f1133/CAN-BUS-FOC-Actuator/README.md

# CAN-BUS FOC Actuator

A CAN-bus FOC controller for cycloidal robot-arm joints, built as a **carrier
board for the SimpleFOC Mini** (DRV8313): on-board STM32G431, 2-shunt inline
current sensing (INA240), AS5600 motor encoder plus two SPI ports for a
joint-side absolute encoder, 1 Mbps CAN, three boards on one bus. Designed
around the parts already on hand (Robu.in invoice 3680169, connector order
ST030926127752, SimpleFOC Mini, STM32G431CBT6, ERJ8CW shunts, SS14, THT kit)
with four things left to buy.

## Spin-1 design point

| | |
|---|---|
| Power stage | SimpleFOC Mini (DRV8313) plugged into the carrier — 3-PWM + EN, nFAULT → TIM1 break |
| DC bus | **12 V only** (8–15 V), one shared 5 A PSU over the CAN harness, passed through each board |
| Phase current | ≤ 2.5 A peak (DRV8313; INA240 range matches) — at 12 V a gimbal winding limits it first, see `docs/08` |
| Current sense | 2 × INA240A1 inline, one 30 mΩ per phase between the Mini and the motor |
| Power | AMS1117-3.3 straight off the 12 V bus — no switcher (0.66 W, pour copper on the tab) |
| MCU | STM32G431CBT6 @ 170 MHz — CORDIC, FMAC, dual ADC |
| Encoders | J3: AS5600 (I2C) + NTC on one 5-pin cable · J4/J5: SPI (MT6701 / AS5047P), motor side and output side |
| Bus | SN65HVD230 1 Mbps classic CAN (TCAN332 drop-in), node ID by solder straps |
| PCB | ~60 × 60 mm, 2-layer, Lion Circuits |
| Spin 2 | discrete bridge with the AO3400s on hand → ±5 A (documented, `-DBRIDGE_DISCRETE`) |

## Read in order

1. [`docs/01-parts-analysis.md`](docs/01-parts-analysis.md) — what the parts on hand can do, sufficiency for 3 boards, the 4-line buy list.
2. [`docs/02-hardware-architecture.md`](docs/02-hardware-architecture.md) — block diagram, power tree, Mini socket, sensing, connectors, protection.
3. [`docs/03-pin-assignment.md`](docs/03-pin-assignment.md) — LQFP-48 pin map with the Mini header mapping, conflicts found and resolved.
4. [`docs/04-firmware-capability.md`](docs/04-firmware-capability.md) — loop structure, CPU budget, dual-encoder scheme, bring-up order.
5. [`docs/05-can-protocol.md`](docs/05-can-protocol.md) — frame layout.
6. [`docs/06-spin1-decisions.md`](docs/06-spin1-decisions.md) — decisions, ranked bottleneck upgrades, encoder mounting, first-PCB checklist.
7. [`docs/07-single-board-bom-and-wiring.md`](docs/07-single-board-bom-and-wiring.md) — module wiring (what plugs into what), the three-joint harness, the cable list, pin-by-pin connections and the designator-level BOM (generated).
8. [`docs/08-board-spec-and-arm-capability.md`](docs/08-board-spec-and-arm-capability.md) — final board specification and what the arm gets from it (generated).

## KiCad project

`hardware/kicad/` holds a generated, verified KiCad 7 project — schematic,
board outline, project symbol/footprint libraries. See
[`hardware/kicad/README.md`](hardware/kicad/README.md). The electrical source
of truth is `tools/board_design.py`; `tools/check_design.py` has KiCad export
the netlist and compares it pin-for-pin against that design.

## Checks

```sh
python3 tools/check_pinmap.py          # 0 conflicts on hardware/pinmap/pinmap.csv
python3 tools/check_bom.py --boards 3  # shortfall table from hardware/bom/*.csv
python3 hardware/calc/design_calcs.py  # every number quoted in docs/
python3 tools/gen_board_docs.py        # regenerates docs/07, docs/08, hardware/wiring/wiring_diagram.svg and the build-sheet page
python3 tools/gen_kicad.py             # regenerates hardware/kicad/ from tools/board_design.py
python3 tools/check_design.py          # kicad-cli netlist vs board_design.py, pin for pin
```

## Layout

```
docs/                     analysis, architecture, decisions
hardware/bom/             inventory.csv (what exists) · per_board.csv (what spin 1 needs)
hardware/calc/            design_calcs.py — sense range, DRV8313 thermal, buck/SS14, cap ratings, PWM, CAN load, AS5600-through-cycloidal, spin-2 reference
hardware/pinmap/          pinmap.csv — single source of truth for the MCU pins
hardware/kicad/           generated KiCad 7 project (schematic, outline, project libs)
hardware/vendor/          SimpleFOC Mini board file (MIT) — the socket footprint is generated from it
firmware/include/         foc_config.h — constants derived from the above (-DBRIDGE_DISCRETE for spin 2)
tools/                    check_pinmap.py · check_bom.py
```

## Next

- [ ] Confirm counts on hand: SimpleFOC Mini ≥ 3, STM32G431CBT6 ≥ 3, ERJ8CWFR030V ≥ 6
- [ ] Confirm the cycloidal ratio and the motor part number (Kv, R); check whether the Minis have male or female headers
- [ ] Buy: male pin header strip, SMBJ15A ×4 (optional), 2-layer PCB ×5
- [ ] Import the netlist into the PCB, place and route the 2-layer board
- [ ] Firmware: SimpleFOC-library bring-up first, then the bare-metal FOC core
