f1133/CAN-BUS-FOC-Actuator/docs/08-board-spec-and-arm-capability.md

# 08 — Board specification & arm capability (spin 1)

Generated by `tools/gen_board_docs.py`; the arm numbers come from `hardware/calc/arm_model.py`.

## Electrical

| | |
|---|---|
| DC bus | 12 V from one shared 5 A PSU over the harness; 8–15 V, the ceiling set by the AMS1117 rather than the DRV8313 |
| Power pass-through | J1 in → J13 out on a ≥ 2 mm trace; the first joint's board carries the whole 5 A |
| Power stage | SimpleFOC Mini (DRV8313): 3-PWM + EN, internal dead time, OCP / UVLO / thermal → nFAULT |
| Phase current | 2.5 A peak (driver) — at 12 V a gimbal motor is voltage-limited to (12 V/√3)/R first; ~1.5 A rms continuous on the Mini's thermal budget |
| Current sense | 2 × INA240A1 inline, 30 mΩ per phase: 0.60 V/A, ±2.5 A full scale, 1.3 mA/LSB, Ic reconstructed |
| PWM / loops | 20 kHz centre-aligned (12.1-bit) · current 20 kHz · velocity 4 kHz · position 1 kHz |
| Logic supply | AMS1117-3.3 straight off the 12 V bus — no switcher. 0.66 W at the itemised 76 mA load; pour copper on the tab. Its 18 V abs max is what fixes the bus at 12 V |
| Sensing | VBUS ÷ 10.1 (8 mV/LSB), motor NTC (10 k, B 3950), MCU die temperature |

## Interfaces

| | |
|---|---|
| CAN | SN65HVD230, classic CAN 1 Mbps, 11-bit IDs, node ID 0–7 by solder straps, 120 Ω termination by jumper on the end boards; 3 joints at 1 kHz ≈ 68 % bus load |
| Motor encoder | AS5600 on the motor (I2C, 12-bit, 1 kHz reads, CONF SF = 2×) on J3 with the winding NTC |
| Joint encoder | J5 SPI (MT6701 / AS5047P, 14-bit) on the cycloidal output — absolute joint angle at power-on |
| Encoder upgrade | J4 SPI for a motor-side MT6701 / AS5047P when speed or latency outgrows the AS5600 |
| Debug | SWD (J11) · UART 115200 (J12) · status LED · SimpleFOC-library compatible pin map |

## Protection

| | |
|---|---|
| Hardware | DRV8313 nFAULT → TIM1 break (outputs idle in one clock) · EN pulled low through reset · bridge-disable jumper R20 |
| Firmware | |I| > 2.8 A · VBUS outside 8–15 V · NTC > 100 °C · encoder error → torque off; CAN heartbeat timeout 100 ms → brake |
| Input | keyed JST-VH, optional SMBJ15A clamp, 2 × 470 µF bulk |

## Physical

| | |
|---|---|
| Board | ~60 × 60 mm, 2-layer 1 oz, Lion Circuits; bottom layer ground pour; 4 × M3 on a 40 mm square + 1 under the Mini |
| Dissipation | ≈ 0.5 W on the carrier; ≈ 1.35 W on the Mini at 1.5 A rms (thermal pad to the carrier pour) |
| Connectors | J1/J13/J6 JST-VH 2P · J2 motor JST-XH 3P · J9/J10 CAN JST-XH 3P · J3 JST-XH 5P · J4/J5/J11/J12 0.1" headers · J7/J8 Mini socket |

## What the arm gets from it

Torque = Kt · Iq · ratio · η with Iq = min(2.5 A, (Vbus/√3)/R). Cycloidal ×15 at 85% is a placeholder; motor rows are typical AS5600-gimbal values — replace with the real motor.

| Motor (typical) | Kv | R | Iq stall | Limit | Motor N·m | Joint N·m | Joint °/s | Bus A holding | AS5600 reads/cycle | Lifts at 0.3 m | Joint N·m at 24 V |
|---|---|---|---|---|---|---|---|---|---|---|---|
| 2804-class gimbal (typical) | 100 | 10.0 Ω | 0.69 A | voltage (V/R) | 0.057 | **0.73** | 408 | 0.63 A | 8.4 | 0.25 kg | 1.46 |
| 3506 / 4108-class gimbal (typical) | 70 | 6.0 Ω | 1.15 A | voltage (V/R) | 0.136 | **1.74** | 286 | 1.03 A | 12.0 | 0.59 kg | 3.48 |
| low-resistance outrunner (typical) | 200 | 0.5 Ω | 2.50 A | driver 2.5 A | 0.103 | **1.32** | 816 | 0.42 A | 4.2 | 0.45 kg | 1.32 |

* Three joints all holding at stall draw ≤ 3.1 A of the 5 A PSU with these motors.
* At 12 V the winding resistance, not the driver, sets torque for gimbal motors; 24 V doubles it with no board change.
* AS5600 stays ≥ 10 reads per electrical cycle to ~1000 rpm; faster motors want the J4 SPI encoder.
* Joint-absolute position comes from the J5 encoder on the cycloidal output.
