f1133/CAN-BUS-FOC-Actuator/hardware/kicad/can-foc-actuator.kicad_sch

## KiCad design hardware/kicad/can-foc-actuator.kicad_sch (2026-09-14, an earlier design)

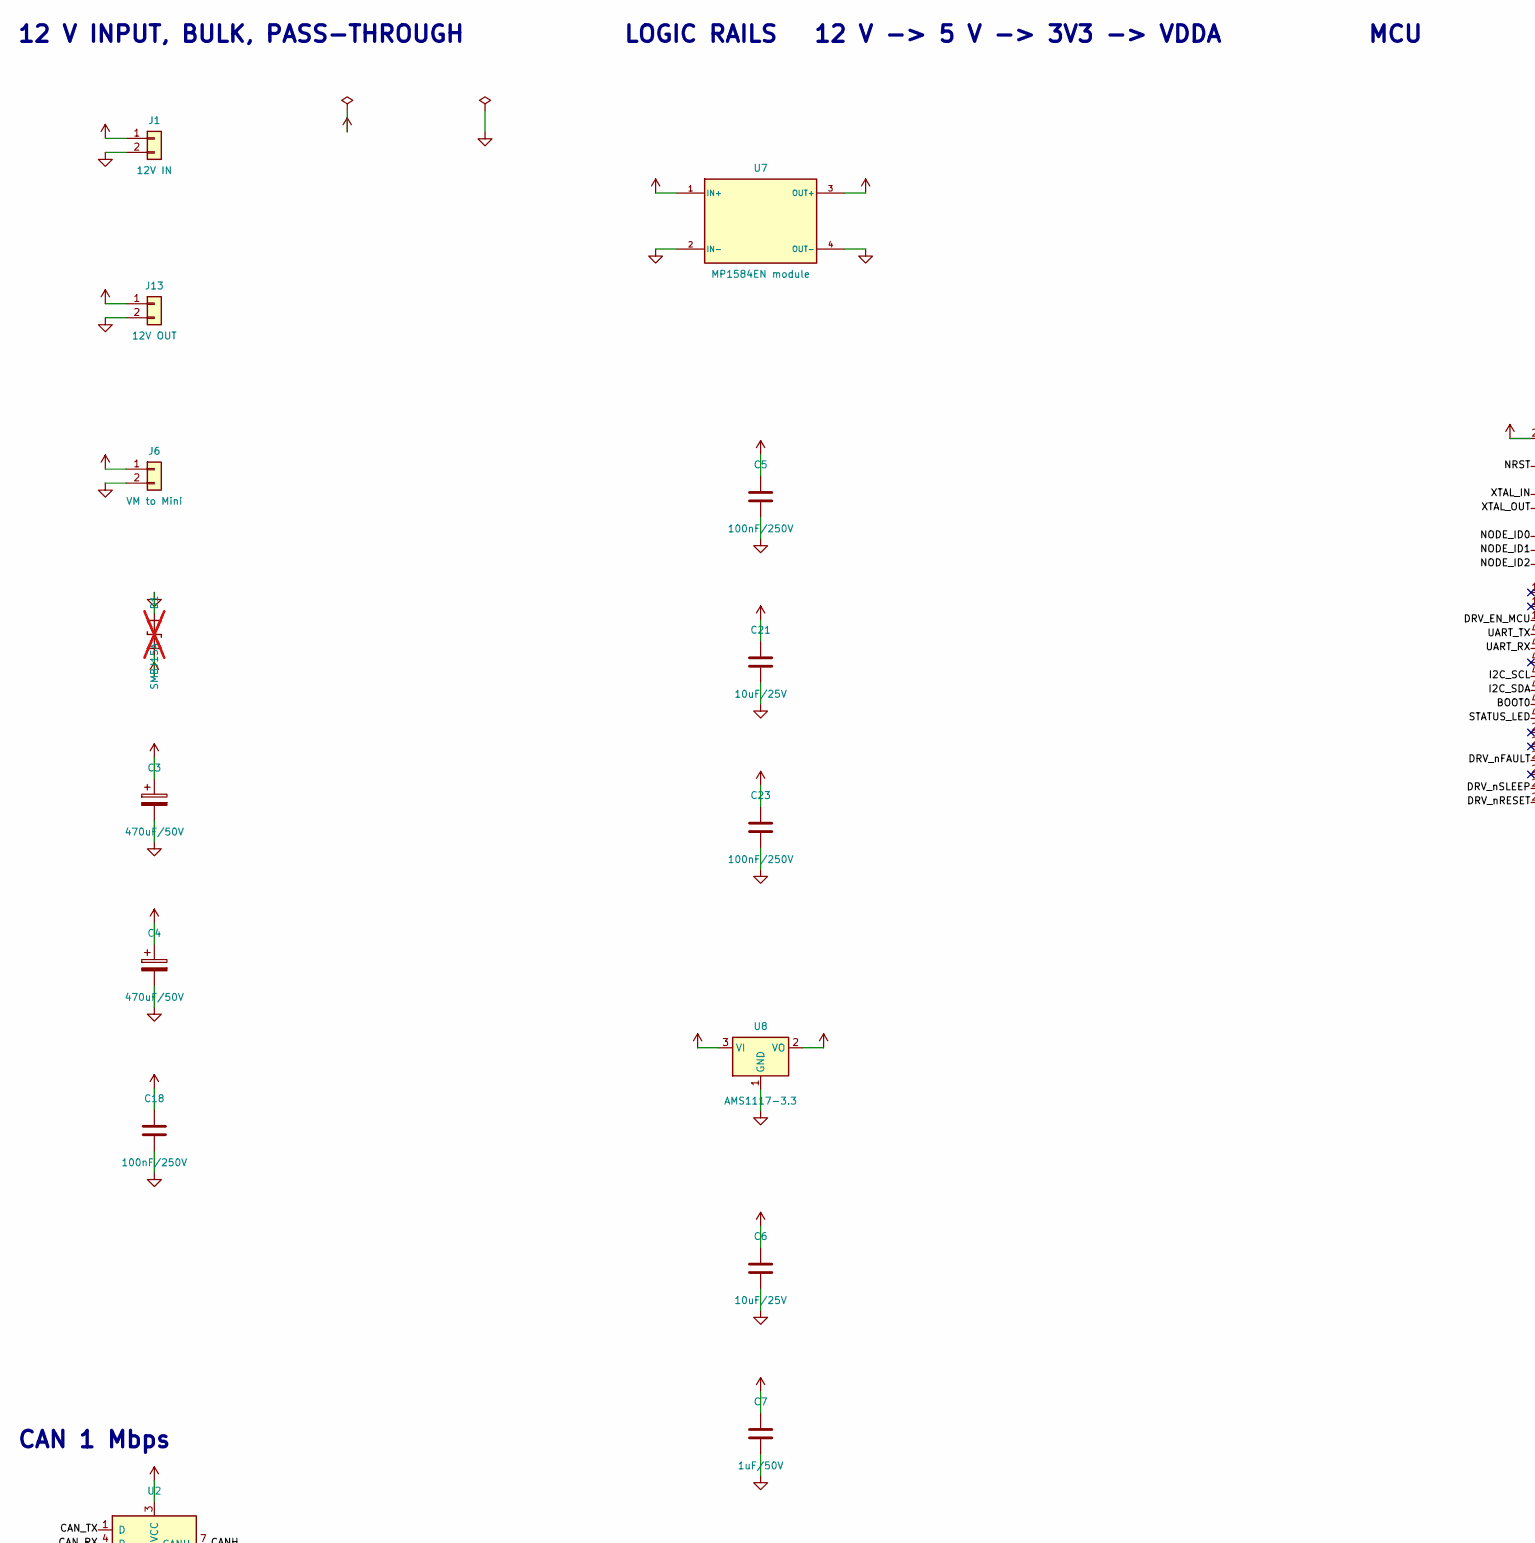
[picture p1: schematic can-foc-actuator.kicad_sch, part in row 1, column 1]

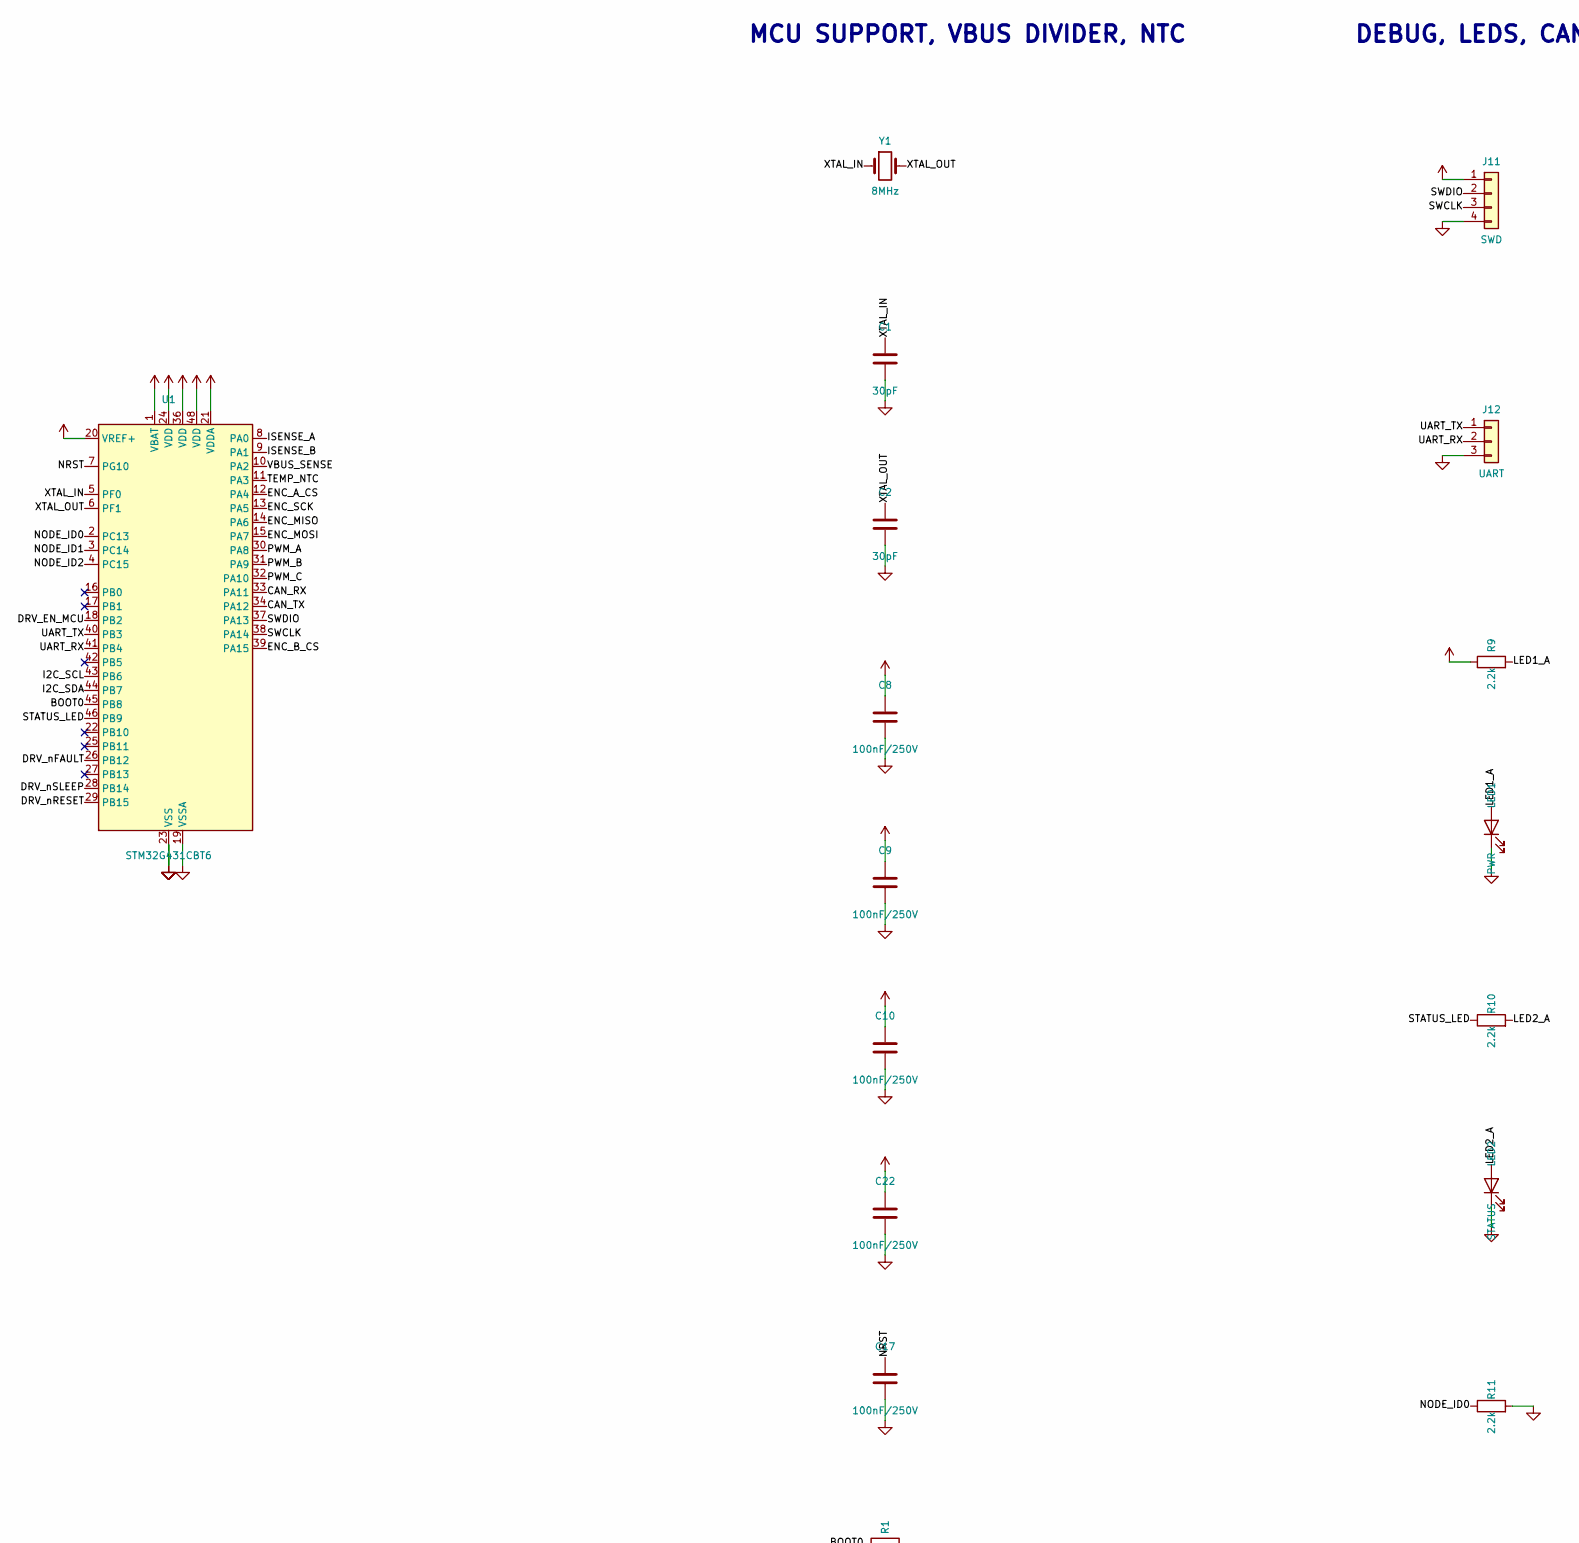
[picture p2: schematic can-foc-actuator.kicad_sch, part in row 1, column 2]

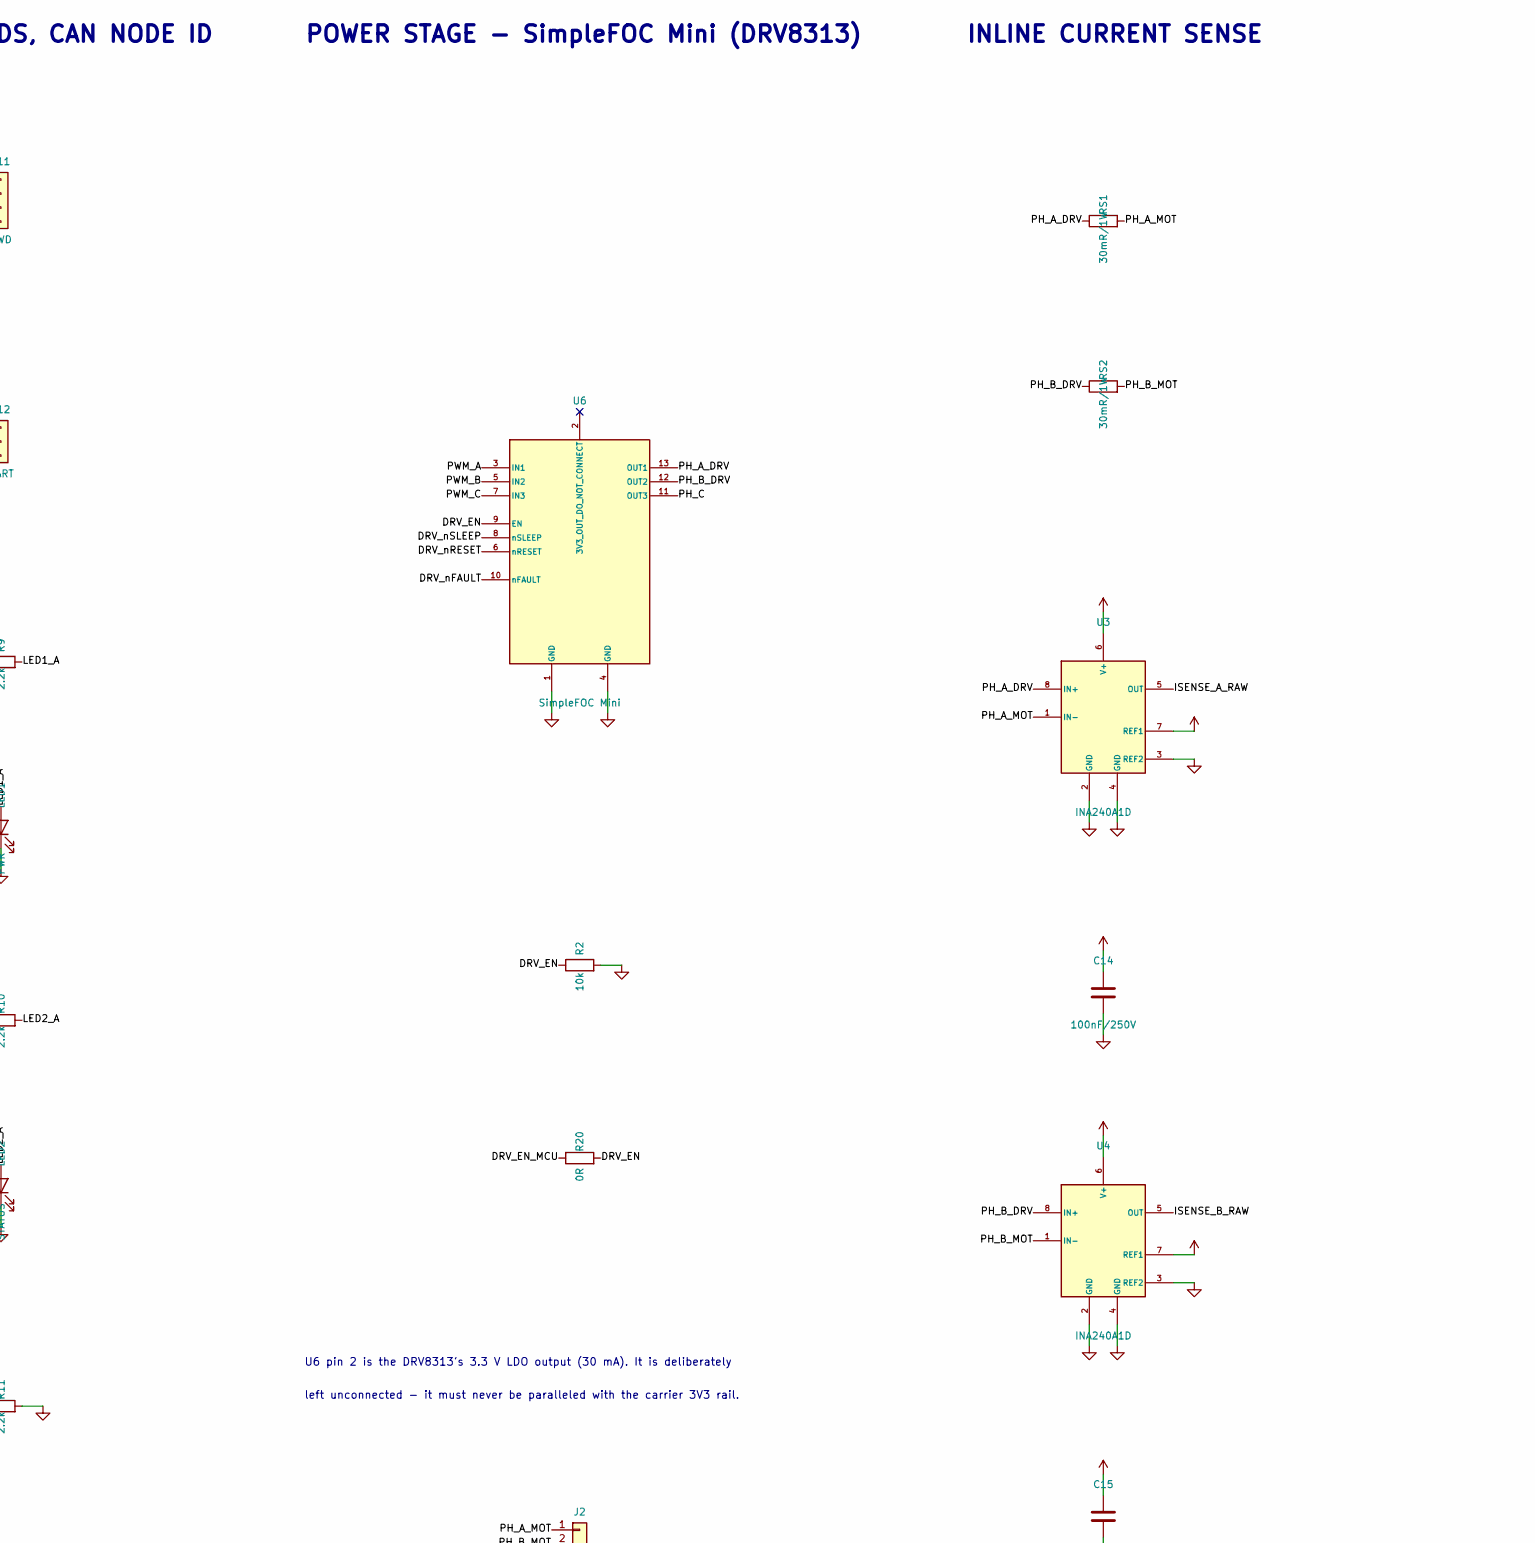
[picture p3: schematic can-foc-actuator.kicad_sch, part in row 1, column 3]

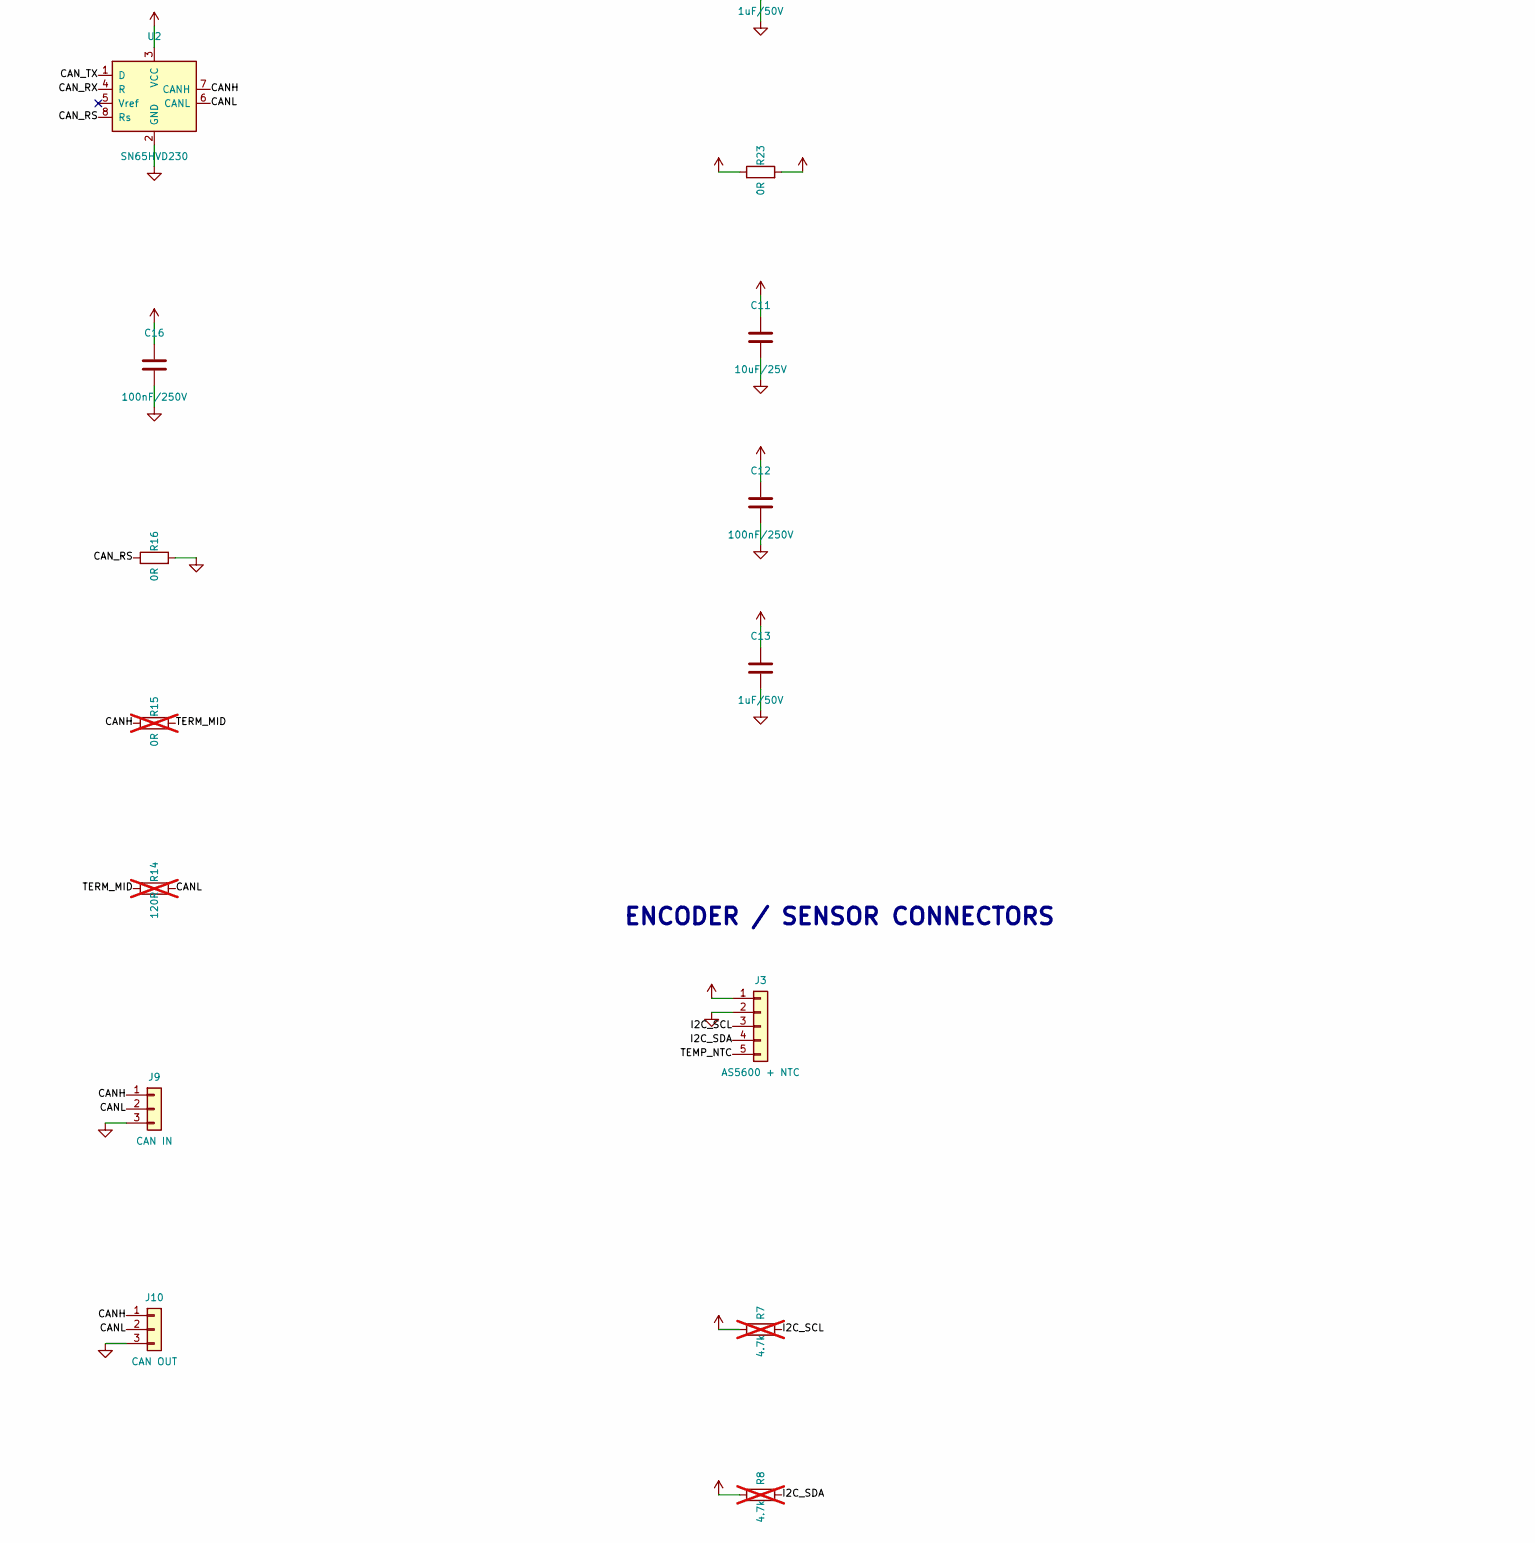
[picture p4: schematic can-foc-actuator.kicad_sch, part in row 2, column 1]

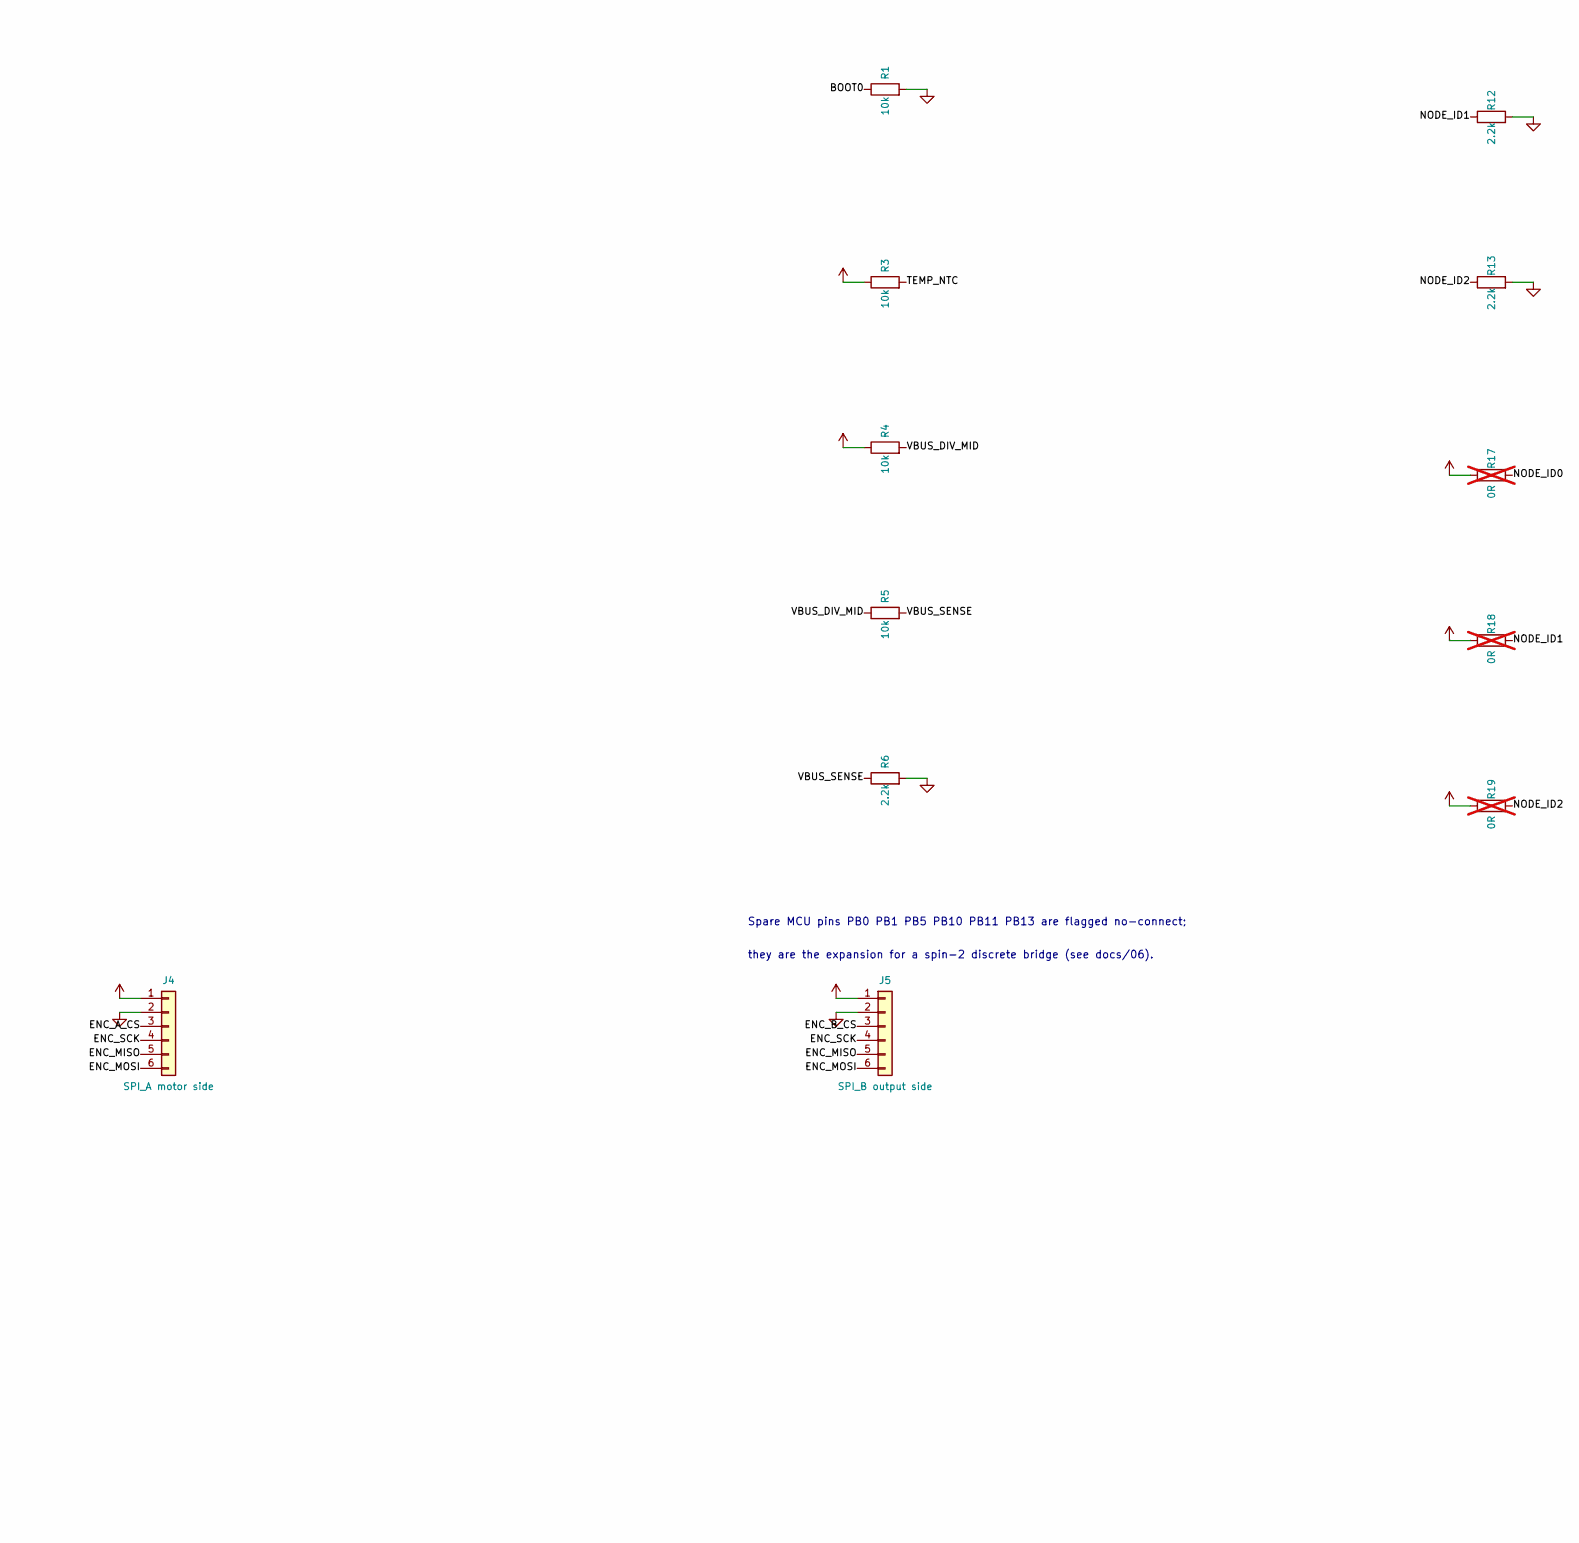
[picture p5: schematic can-foc-actuator.kicad_sch, part in row 2, column 2]

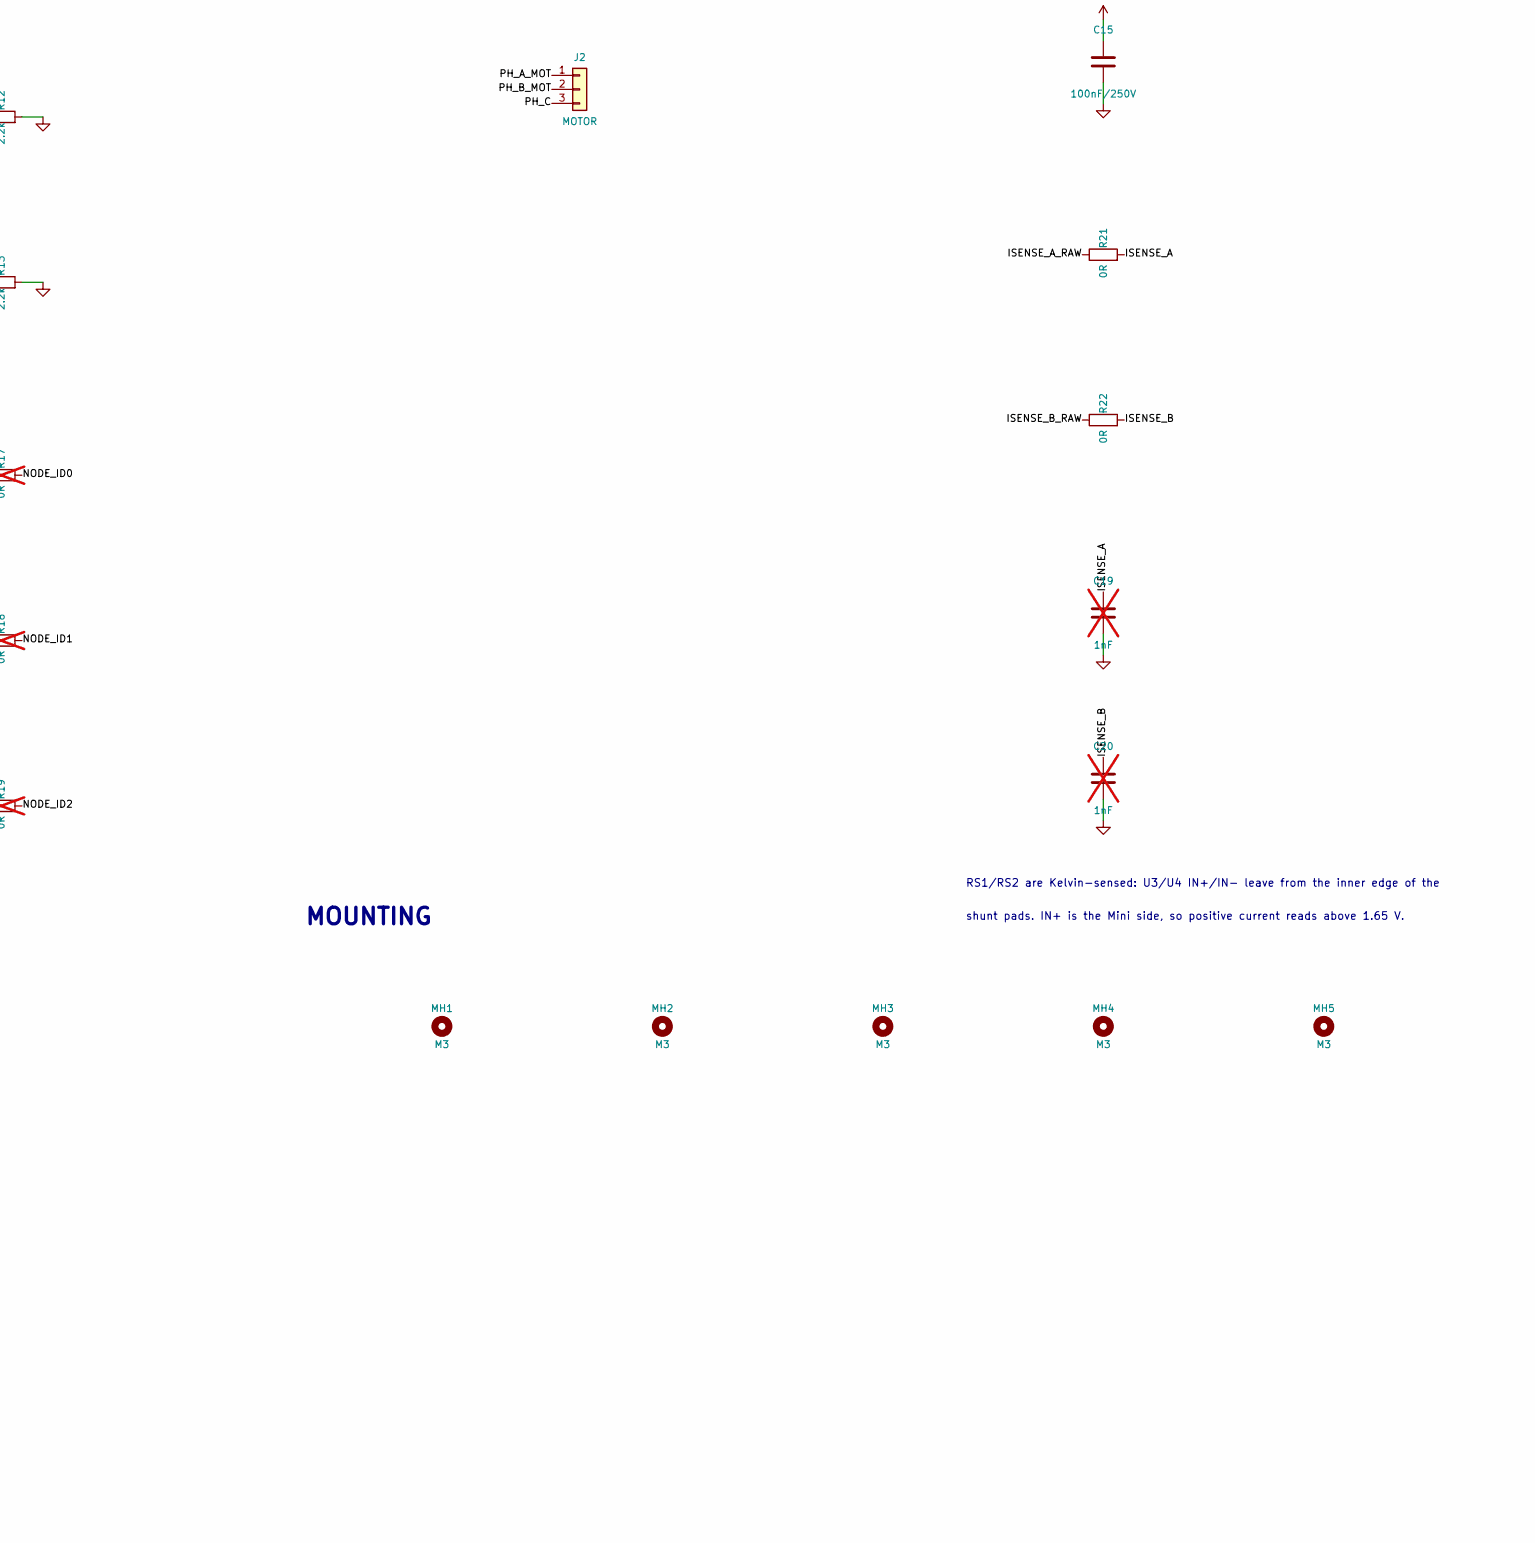
[picture p6: schematic can-foc-actuator.kicad_sch, part in row 2, column 3]

Parts:
C1, C2: 30pF; C_1206_3216Metric
C3, C4: 470uF/50V; CP_Elec_10x10.5
C5, C8, C9, C10, C12, C14, C15, C16, C17, C18, C22, C23: 100nF/250V; C_1206_3216Metric
C6, C11, C21: 10uF/25V; C_1206_3216Metric
C7, C13: 1uF/50V; C_1206_3216Metric
C19, C20: 1nF; C_1206_3216Metric; not fitted
D1: SMBJ15A; D_SMB; not fitted
J1: 12V IN; JST_VH_B2P-VH_1x02_P3.96mm_Vertical
J2: MOTOR; JST_XH_B3B-XH-A_1x03_P2.50mm_Vertical
J3: AS5600 + NTC; JST_XH_B5B-XH-A_1x05_P2.50mm_Vertical
J4: SPI_A motor side; PinHeader_1x06_P2.54mm_Vertical
J5: SPI_B output side; PinHeader_1x06_P2.54mm_Vertical
J6: VM to Mini; JST_VH_B2P-VH_1x02_P3.96mm_Vertical
J9: CAN IN; JST_XH_B3B-XH-A_1x03_P2.50mm_Vertical
J10: CAN OUT; JST_XH_B3B-XH-A_1x03_P2.50mm_Vertical
J11: SWD; PinHeader_1x04_P2.54mm_Vertical
J12: UART; PinHeader_1x03_P2.54mm_Vertical
J13: 12V OUT; JST_VH_B2P-VH_1x02_P3.96mm_Vertical
LED1: PWR; LED_1206_3216Metric
LED2: STATUS; LED_1206_3216Metric
MH1, MH2, MH3, MH4, MH5: M3; MountingHole_3.2mm_M3
R1, R2, R3, R4, R5: 10k; R_1206_3216Metric
R6, R9, R10, R11, R12, R13: 2.2k; R_1206_3216Metric
R7, R8: 4.7k; R_1206_3216Metric; not fitted
R14: 120R; R_1206_3216Metric; not fitted
R15, R17, R18, R19: 0R; R_1206_3216Metric; not fitted
R16, R20, R21, R22, R23: 0R; R_1206_3216Metric
RS1, RS2: 30mR/1W; R_1206_3216Metric
U1: STM32G431CBT6; LQFP-48_7x7mm_P0.5mm
U2: SN65HVD230; SOIC-8_3.9x4.9mm_P1.27mm
U3, U4: INA240A1D; SOIC-8_3.9x4.9mm_P1.27mm
U6: SimpleFOC Mini; SimpleFOC_Mini_Socket
U7: MP1584EN module; MP1584_Module_4pin
U8: AMS1117-3.3; SOT-223-3_TabPin2
Y1: 8MHz; Crystal_SMD_HC49-SD_HandSoldering

Connections:
+3V3: C6.1, C7.1, C8.1, C9.1, C10.1, C14.1, C15.1, C16.1, C22.1, J3.1, J4.1, J5.1, J11.1, R3.1, R7.1, R8.1, R9.1, R17.1, R18.1, R19.1, R23.1, U1.1 (VBAT), U1.24 (VDD), U1.36 (VDD), U1.48 (VDD), U2.3 (VCC), U3.6 (V+), U3.7 (REF1), U4.6 (V+), U4.7 (REF1), U8.2 (VO)
+5V: C21.1, C23.1, U7.3 (OUT+), U8.3 (VI)
BOOT0: R1.1, U1.45 (PB8)
CANH: J9.1, J10.1, R15.1, U2.7 (CANH)
CANL: J9.2, J10.2, R14.2, U2.6 (CANL)
CAN_RS: R16.1, U2.8 (Rs)
CAN_RX: U1.33 (PA11), U2.4 (R)
CAN_TX: U1.34 (PA12), U2.1 (D)
DRV_EN: R2.1, R20.2, U6.9 (EN)
DRV_EN_MCU: R20.1, U1.18 (PB2)
DRV_nFAULT: U1.26 (PB12), U6.10 (nFAULT)
DRV_nRESET: U1.29 (PB15), U6.6 (nRESET)
DRV_nSLEEP: U1.28 (PB14), U6.8 (nSLEEP)
ENC_A_CS: J4.3, U1.12 (PA4)
ENC_B_CS: J5.3, U1.39 (PA15)
ENC_MISO: J4.5, J5.5, U1.14 (PA6)
ENC_MOSI: J4.6, J5.6, U1.15 (PA7)
ENC_SCK: J4.4, J5.4, U1.13 (PA5)
GND: C1.2, C2.2, C3.2, C4.2, C5.2, C6.2, C7.2, C8.2, C9.2, C10.2, C11.2, C12.2, C13.2, C14.2, C15.2, C16.2, C17.2, C18.2, C19.2, C20.2, C21.2, C22.2, C23.2, D1.2 (A2), J1.2, J3.2, J4.2, J5.2, J6.2, J9.3, J10.3, J11.4, J12.3, J13.2, LED1.1 (K), LED2.1 (K), R1.2, R2.2, R6.2, R11.2, R12.2, R13.2, R16.2, U1.19 (VSSA), U1.23 (VSS), U1.35 (VSS), U1.47 (VSS), U2.2 (GND), U3.2 (GND), U3.3 (REF2), U3.4 (GND), U4.2 (GND), U4.3 (REF2), U4.4 (GND), U6.1 (GND), U6.4 (GND), U7.2 (IN-), U7.4 (OUT-), U8.1 (GND)
I2C_SCL: J3.3, R7.2, U1.43 (PB6)
I2C_SDA: J3.4, R8.2, U1.44 (PB7)
ISENSE_A: C19.1, R21.2, U1.8 (PA0)
ISENSE_A_RAW: R21.1, U3.5 (OUT)
ISENSE_B: C20.1, R22.2, U1.9 (PA1)
ISENSE_B_RAW: R22.1, U4.5 (OUT)
LED1_A: LED1.2 (A), R9.2
LED2_A: LED2.2 (A), R10.2
NODE_ID0: R11.1, R17.2, U1.2 (PC13)
NODE_ID1: R12.1, R18.2, U1.3 (PC14)
NODE_ID2: R13.1, R19.2, U1.4 (PC15)
NRST: C17.1, U1.7 (PG10)
PH_A_DRV: RS1.1, U3.8 (IN+), U6.13 (OUT1)
PH_A_MOT: J2.1, RS1.2, U3.1 (IN-)
PH_B_DRV: RS2.1, U4.8 (IN+), U6.12 (OUT2)
PH_B_MOT: J2.2, RS2.2, U4.1 (IN-)
PH_C: J2.3, U6.11 (OUT3)
PWM_A: U1.30 (PA8), U6.3 (IN1)
PWM_B: U1.31 (PA9), U6.5 (IN2)
PWM_C: U1.32 (PA10), U6.7 (IN3)
STATUS_LED: R10.1, U1.46 (PB9)
SWCLK: J11.3, U1.38 (PA14)
SWDIO: J11.2, U1.37 (PA13)
TEMP_NTC: J3.5, R3.2, U1.11 (PA3)
TERM_MID: R14.1, R15.2
UART_RX: J12.2, U1.41 (PB4)
UART_TX: J12.1, U1.40 (PB3)
VBUS: C3.1, C4.1, C5.1, C18.1, D1.1 (A1), J1.1, J6.1, J13.1, R4.1, U7.1 (IN+)
VBUS_DIV_MID: R4.2, R5.1
VBUS_SENSE: R5.2, R6.1, U1.10 (PA2)
VDDA: C11.1, C12.1, C13.1, R23.2, U1.20 (VREF+), U1.21 (VDDA)
XTAL_IN: C1.1, U1.5 (PF0), Y1.1
XTAL_OUT: C2.1, U1.6 (PF1), Y1.2

Notes on the sheet:
12 V INPUT, BULK, PASS-THROUGH
CAN 1 Mbps
LOGIC RAILS 12 V -> 5 V -> 3V3 -> VDDA
ENCODER / SENSOR CONNECTORS
MCU
MCU SUPPORT, VBUS DIVIDER, NTC
DEBUG, LEDS, CAN NODE ID
POWER STAGE - SimpleFOC Mini (DRV8313)
INLINE CURRENT SENSE
MOUNTING
U6 pin 2 is the DRV8313's 3.3 V LDO output (30 mA). It is deliberately
left unconnected - it must never be paralleled with the carrier 3V3 rail.
RS1/RS2 are Kelvin-sensed: U3/U4 IN+/IN- leave from the inner edge of the
shunt pads. IN+ is the Mini side, so positive current reads above 1.65 V.
Spare MCU pins PB0 PB1 PB5 PB10 PB11 PB13 are flagged no-connect;
they are the expansion for a spin-2 discrete bridge (see docs/06).
