f1133/CAN-BUS-FOC-Actuator/firmware/include/foc_config.h

/**
 * foc_config.h — board-level constants for the CAN-BUS FOC actuator.
 *
 * Spin 1: STM32G431 carrier with a SimpleFOC Mini (DRV8313) as the power
 * stage.  Every value is derived in hardware/calc/design_calcs.py and
 * documented in docs/04-firmware-capability.md §5.  Build with
 * -DBRIDGE_DISCRETE for the spin-2 6-PWM bridge (docs/06).
 */
#ifndef FOC_CONFIG_H
#define FOC_CONFIG_H

/* ---- Clocks ------------------------------------------------------------ */
#define SYSCLK_HZ                 170000000UL   /* 8 MHz HSE, PLLM=2 PLLN=85 PLLR=2 */
#define HSE_HZ                    8000000UL

/* ---- PWM / TIM1 -------------------------------------------------------- */
#define PWM_FREQ_HZ               20000U
#define TIM1_ARR                  (SYSCLK_HZ / (2U * PWM_FREQ_HZ))   /* 4250, centre-aligned */
#define PWM_MAX_DUTY              0.96f

#ifndef BRIDGE_DISCRETE
/* SimpleFOC Mini / DRV8313: 3-PWM + EN.  Dead time is inside the DRV8313. */
#define DRIVER_3PWM               1
#define TIM1_DTG                  0U
#else
/* Spin 2: FD6288T + discrete FETs, 6-PWM with complementary outputs. */
#define DRIVER_6PWM               1
#define DEAD_TIME_NS              400U
#define TIM1_DTG                  ((DEAD_TIME_NS * (SYSCLK_HZ / 1000000UL)) / 1000U) /* 68 */
#endif

/* ---- Loop rates -------------------------------------------------------- */
#define CURRENT_LOOP_HZ           PWM_FREQ_HZ
#define VELOCITY_LOOP_DIV         5U          /* 4 kHz  */
#define POSITION_LOOP_DIV         20U         /* 1 kHz  */

/* ---- Current sense: INA240A1 (20 V/V) + ERJ8CWFR030V inline ------------ */
#define CSA_GAIN                  20.0f
#ifndef BRIDGE_DISCRETE
#define SHUNT_OHM                 0.030f      /* one 30 mOhm per phase */
#define I_MAX_A                   2.5f        /* = INA240 swing = DRV8313 peak */
#define I_TRIP_A                  2.8f
#define I_CONT_A_RMS              1.5f        /* DRV8313 thermal on the Mini */
#else
#define SHUNT_OHM                 0.015f      /* 2 x 30 mOhm in parallel */
#define I_MAX_A                   5.0f
#define I_TRIP_A                  5.5f
#define I_CONT_A_RMS              3.5f
#endif
#define ISENSE_V_PER_A            (SHUNT_OHM * CSA_GAIN)
#define ISENSE_OFFSET_V_NOMINAL   1.65f       /* REF = VS/2, auto-cal at boot */
#define CURRENT_SENSE_PHASES      2           /* Ic = -(Ia+Ib) */

/* ---- ADC --------------------------------------------------------------- */
#define ADC_VREF_V                3.3f
#define ADC_BITS                  12U
#define ADC_V_PER_LSB             (ADC_VREF_V / (float)(1U << ADC_BITS))
#define VBUS_DIV_TOP_OHM          20000.0f    /* 2 x 10k series */
#define VBUS_DIV_BOT_OHM          2200.0f
#define VBUS_V_PER_LSB            (ADC_V_PER_LSB * (VBUS_DIV_TOP_OHM + VBUS_DIV_BOT_OHM) / VBUS_DIV_BOT_OHM)
#define NTC_R25_OHM               10000.0f
#define NTC_BETA                  3950.0f
#define NTC_PULLUP_OHM            10000.0f

/* ---- Bus limits -------------------------------------------------------- */
#ifndef BRIDGE_DISCRETE
/* The 3V3 rail is an AMS1117 fed straight off the bus, so the LDO - not the
 * DRV8313 - sets the ceiling: 18 V absolute max, and 0.87 W of dissipation
 * already at 12 V.  This build is a 12 V system; a higher bus needs a
 * switching pre-regulator back in front of the LDO. */
#define VBUS_MIN_V                8.0f        /* DRV8313 UVLO */
#define VBUS_MAX_V                15.0f       /* LDO thermal limit, not the driver's */
#define VBUS_NOMINAL_V            12.0f
#define LDO_VIN_ABS_MAX_V         18.0f
#define LOGIC_LOAD_BUDGET_A       0.12f       /* keep the 3V3 load under this or the LDO cooks */
#define PSU_CURRENT_A             5.0f        /* one PSU shared by all joints over the CAN harness */
#define N_JOINTS                  3U
#elif defined(BRIDGE_FET_AOD4184)
#define VBUS_MIN_V                10.0f
#define VBUS_MAX_V                28.0f
#define VBUS_NOMINAL_V            24.0f
#else                                         /* AO3400A, 30 V */
#define VBUS_MIN_V                10.0f
#define VBUS_MAX_V                20.0f
#define VBUS_NOMINAL_V            16.0f
#endif

/* ---- Encoders ---------------------------------------------------------- */
/* Motor side (commutation): AS5600 on I2C1, J3.  Upgrade path: SPI on J4. */
#define ENC_M_TYPE_AS5600         1
#define ENC_M_BITS                12U
#define ENC_M_CPR                 (1U << ENC_M_BITS)
#define ENC_M_I2C_ADDR            0x36U
#define ENC_M_I2C_HZ              400000UL
#define ENC_M_READ_HZ             1000U       /* angle extrapolated with omega at PWM rate */
#define AS5600_CONF_SF            3U          /* slow filter 2x -> 0.29 ms (default 16x = 2.2 ms) */
#define AS5600_CONF_FTH           6U          /* fast-filter threshold 10 LSB */
/* Output side (joint position, absolute through the cycloidal): SPI on J5. */
#define ENC_J_BITS                14U         /* MT6701 / AS5047P */
#define ENC_J_SPI_HZ              1000000UL
#define GEAR_RATIO                15.0f       /* cycloidal — set to the real ratio */

/* ---- CAN --------------------------------------------------------------- */
#define CAN_BITRATE               1000000UL   /* SN65HVD230 limit */
#define CAN_HEARTBEAT_TIMEOUT_MS  100U
#define CAN_FEEDBACK_HZ           1000U
#define CAN_STATUS_HZ             10U

/* ---- Pins (docs/03-pin-assignment.md) ---------------------------------- */
#define PIN_PWM_A    GPIOA, 8    /* TIM1_CH1 AF6 -> Mini H1.3 IN1 */
#define PIN_PWM_B    GPIOA, 9    /* TIM1_CH2 AF6 -> Mini H1.5 IN2 */
#define PIN_PWM_C    GPIOA, 10   /* TIM1_CH3 AF6 -> Mini H1.7 IN3 */
#ifdef BRIDGE_DISCRETE
#define PIN_PWM_AL   GPIOB, 13   /* TIM1_CH1N AF6 */
#define PIN_PWM_BL   GPIOB, 14   /* TIM1_CH2N AF6 */
#define PIN_PWM_CL   GPIOB, 15   /* TIM1_CH3N AF4 (!) */
#else
#define PIN_DRV_NSLP GPIOB, 14   /* -> Mini H1.8 nSLEEP */
#define PIN_DRV_NRST GPIOB, 15   /* -> Mini H1.6 nRESET */
#endif
#define PIN_DRV_FLT  GPIOB, 12   /* TIM1_BKIN AF6 <- Mini H1.10 nFAULT (active low) */
#define PIN_DRV_EN   GPIOB, 2    /* -> Mini H1.9 EN */
#define PIN_ISENSE_A GPIOA, 0    /* ADC1_IN1 */
#define PIN_ISENSE_B GPIOA, 1    /* ADC2_IN2 */
#define PIN_VBUS     GPIOA, 2    /* ADC1_IN3 */
#define PIN_NTC      GPIOA, 3    /* ADC1_IN4 */
#define PIN_ENC_A_CS GPIOA, 4    /* J4 SPI_A (motor side, future) */
#define PIN_ENC_B_CS GPIOA, 15   /* J5 SPI_B (output side) */
#define PIN_ENC_SCK  GPIOA, 5    /* SPI1 AF5 */
#define PIN_ENC_MISO GPIOA, 6    /* SPI1 AF5 */
#define PIN_ENC_MOSI GPIOA, 7    /* SPI1 AF5 */
#define PIN_CAN_RX   GPIOA, 11   /* FDCAN1 AF9 */
#define PIN_CAN_TX   GPIOA, 12   /* FDCAN1 AF9 */
#define PIN_UART_TX  GPIOB, 3    /* USART2 AF7 */
#define PIN_UART_RX  GPIOB, 4    /* USART2 AF7 */
#define PIN_I2C_SCL  GPIOB, 6    /* I2C1 AF4 — AS5600, J3 */
#define PIN_I2C_SDA  GPIOB, 7    /* I2C1 AF4 */
#define PIN_LED      GPIOB, 9
#define PIN_ID0      GPIOC, 13
#define PIN_ID1      GPIOC, 14
#define PIN_ID2      GPIOC, 15

#endif /* FOC_CONFIG_H */
