f1133/CAN-BUS-FOC-Actuator/(commit log)

2026-09-13 Add parts analysis, hardware architecture and pin map for CAN FOC actuator
    Analyse the Robu.in invoice 3680169, the connector order, the SimpleFOCMini
    reference design and the Lion Circuits sample Gerber against the goal of
    three identical CAN-bus FOC drivers for robot-arm joints built around
    STM32G431CBT6 + 6x AO3400 + INA240A1 + ERJ8CWFR030V.
    docs/
    01 parts analysis: capability of the board as specified, sufficiency for
    3 boards, missing parts (gate driver, 5 V buck IC, 10 V gate rail,
    22 R gate resistors, TVS, encoder, 4-layer PCB), why the single-sided
    copper clad is not usable.
    02 hardware architecture: power tree (24 V -> buck 5 V -> AMS1117 3.3 V,
    linear 10 V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
    [inventory.csv, per_board.csv, pinmap.csv]
2026-09-13 Spin-1 decisions: 24 V AOD4184 bridge, no 5 V rail, AS5600 + dual SPI encoders, 2-layer
    Fold the first-PCB decisions into the design:
    - Bus 24 V with AOD4184 (TO-252, 40 V, 8 mOhm) replacing the 30 V AO3400,
    which capped the bus at 16 V and was the thermal limit. AO3400 kept as a
    16 V build (-DBRIDGE_FET_AO3400). Vgs rail stays 10 V (78L10).
    - Delete the 5 V rail and AMS1117: MP1584EN runs straight to 3.3 V with the
    CD43 3.3 uH (t_on 137 ns at 24 V, ripple 0.86 A, DCM); feedback from stock
    10k+4k7 / 4k7. Everything analog is ratiometric to the same rail.
    - AS5600-mounted motors: I2C1 on J3 (3V3 GND SCL SDA NTC) is the default
    encoder; SPI-mode jumpers and MT6701 purchase remove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
    [inventory.csv, per_board.csv, pinmap.csv]
2026-09-13 Buy list: account for bought AO3400 / ERJ8CW / STM32G431, default to 16 V build
    All parts shared so far (invoice, connector order, AO3400, ERJ8CWFR030V,
    STM32G431CBT6) are on hand, and one board drives one motor. Spin 1 therefore
    uses the bought AO3400s at 16 V and buys nothing for the bridge; AOD4184/24 V
    becomes the optional upgrade (-DBRIDGE_FET_AOD4184), flagged as a footprint
    decision to make before layout.
    - inventory.csv: the three user-listed parts marked BOUGHT (count not
    confirmed); check_bom.py reports them as "confirm you have >= N" instead of
    unknown. per_board.csv: AO3400A as the bridge, SMBJ18A TVS, zener option
    for the 10 V rail.
    - foc_config.h: default VBUS limits 1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
    [inventory.csv, per_board.csv]
2026-09-13 Pivot spin 1 to a SimpleFOC Mini carrier; SS14 and THT kit on hand; buy list down to 4 lines
    The SimpleFOC Mini (DRV8313) is the power stage and plugs into the board,
    so the carrier carries only the STM32G431, CAN, 2x INA240 inline sense, the
    3.3 V buck, encoder ports and the Mini socket. The discrete bridge (gate
    driver, 10 V rail, gate resistors, AO3400/AOD4184) moves to a documented
    spin 2 behind -DBRIDGE_DISCRETE.
    - Mini header mapping taken from its PCB nets: H1 = GND, 3.3V-out (left
    unconnected: 30 mA LDO, must not parallel the carrier rail), IN1, GND, IN2,
    nRESET, IN3, nSLEEP, EN, nFAULT; P1 = OUT3, OUT2, OUT1. VM/GND by a wire
    pair from a second JST-VH to the Mini's screw te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
    [inventory.csv, per_board.csv, pinmap.csv]
2026-09-14 Single-board BOM, netlist and wiring diagram; 12 V shared PSU; spec and arm capability
    Add the build sheet for one carrier board, generated from two CSV sources so
    the repo and the published page cannot disagree:
    - hardware/bom/single_board_bom.csv — designator-level BOM (U1..U8, C1..C23,
    R1..R23, RS1/RS2, J1..J13, off-board and mechanical) with on-hand / confirm /
    buy / optional / DNP status.
    - hardware/wiring/netlist.csv — pin-by-pin connections by block (Mini H1/P1
    sockets from the Mini's own PCB nets, power, MCU support, INA240s, CAN,
    every connector).
    - tools/gen_board_docs.py — draws hardware/wiring/wiring_diagram.svg (native
    SVG, theme-aware in the page, literal colou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
    [inventory.csv, netlist.csv, per_board.csv, single_board_bom.csv]
2026-09-14 Add generated KiCad 7 project, verified against the design netlist
    hardware/kicad/ is a complete, openable KiCad project for the spin-1 carrier:
    single-sheet A1 schematic (75 components, 52 nets), 60 x 60 mm board outline,
    project symbol and footprint libraries, and net classes. Nothing in it is
    hand-written.
    - tools/board_design.py is the electrical source of truth: every component,
    every pin, every net.
    - tools/gen_kicad.py renders the project. Connectivity is drawn as a net
    label on each pin (power pins get a stub and a power symbol), so the netlist
    is unambiguous; spare MCU pins carry explicit no-connect flags.
    - tools/check_design.py has kicad-cli export the netlist KiCad itsel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
    [can-foc-actuator.kicad_pcb, can-foc-actuator.kicad_sch, netlist.csv, single_board_bom.csv]
2026-09-14 Add module-level wiring and three-joint harness diagrams
    The existing wiring diagram is schematic-style: it answers "what connects to
    what" pin by pin. These two answer "what plugs into what", which is the
    question you have in front of you with the parts on the bench.
    - hardware/wiring/module_wiring.svg - one joint with every module drawn as a
    discrete object: the carrier PCB you fabricate (with the MP1584 and AMS1117
    modules on it), the SimpleFOC Mini that plugs into the 13-pin J7/J8 socket
    and takes motor power separately through W1 to its screw terminal, the motor
    with its AS5600 board and winding NTC, the joint encoder on the cycloidal
    output, and the bench tools. Connector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
    [cables.csv]
2026-09-14 Generate the Mini socket from its vendor board file; drop the MP1584, LDO direct
    Two changes.
    1. The SimpleFOC Mini is now properly part of the project rather than
    transcribed into it. hardware/vendor/simplefocmini/ holds the module's own
    EasyEDA PCB export (MIT, byte-identical to the file supplied) plus its
    licence and a provenance note, and tools/gen_kicad.py parses it at build
    time to produce the socket footprint: H1 pads 1-10, P1 pads renumbered
    11-13 (OUT3 OUT2 OUT1), and the silkscreen/courtyard from the board-outline
    layer. The parser reproduces the previously hand-transcribed pad table
    exactly, and additionally gives the real module edge: 23.0 x 21.0 mm runnin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
    [can-foc-actuator.kicad_sch, inventory.csv, netlist.csv, per_board.csv, single_board_bom.csv]
